LBMercado/Assistive-Wearable-Obstacle-Detection-System-using-Atmega328P/Codes/assistive-wearable-obstacle-detection-system/assistive-wearable-obstacle-detection-system.ino

#include "SPI.h"
#include "SD.h"
#include "Adafruit_VS1053.h"
/* --------------------------------------------------------------- */
//uncomment to enable debugging
//#define DEBUG
#include "DebugUtils.h"
/* --------------------------------------------------------------- */
/* Device Operating Configurations */
#ifdef DEBUG
#define BAUD_RATE                       9600
#endif
#define ITERATION_INTERVAL              0       //in milliseconds, amount of time to wait before next iteration
#define TRIGGER_WAIT_DURATION           60      //in milliseconds, wait before sending another trigger signal
#define MAX_DISTANCE                    200     //maximum distance considered in centimeters
#define MIN_DISTANCE                    10      //minimum distance considered in centimeters
#define PWM_VALUE_PERCENTAGE            100     //0 - 100, maximum output percentage PWM for vibration motors, adjust lower to reduce power consumption
#define STAIR_ELEV_DISTANCE             15      //in centimeters
#define VIBRATION_DURATION              100     //in milliseconds
#define DEFAULT_VOLUME                  20      //default starting volume, will adjust based on analog reading on volume adjust potentiometer.
#define VOLUME_ADJ_SENSITIVITY          50      //sensitivity of the volume adjust parameter, lower is more sensitive (1 - 1023)
#define VOLUME_ADJ_MAX                  1023 / VOLUME_ADJ_SENSITIVITY
#if VOLUME_ADJ_SENSITIVITY <= 0
#error "Volume Adjust Sensitivity cannot be less than or equal to zero."
#endif
#define MAX_CONSTANT_VIBRATION_TIME     3000    //in milliseconds
#define CONSTANT_VIBRATION_DIST_TOL     15      //in centimeters
/* --------------------------------------------------------------- */
/* PIN Configuration */
//    ultrasonic sensor pins
const unsigned short US_TRIG_PIN = 4;
const unsigned short US_ECHO_FRONT_PIN = 5;
const unsigned short US_ECHO_LEFT_PIN = 7;
const unsigned short US_ECHO_RIGHT_PIN = 8;
const unsigned short US_ECHO_STAIRS_PIN = 5;
//    PIR sensor pins
const unsigned short PIR_RX_LEFT_PIN = 7;
const unsigned short PIR_RX_RIGHT_PIN = 8;
//    output pin to drive vibration motors
const unsigned short PWM_PIN_RIGHT = 3;
const unsigned short PWM_PIN_FRONT = 6;
const unsigned short PWM_PIN_LEFT = 10;
//    selector pin for choosing between:
//      0 : ultrasonic sensors for general obstacles and common trigger
//      1 : ultrasonic sensor for stair detection, PIR sensors, and microsd card reader
const unsigned short SELECTOR_PIN = 2;
//    SPI pins common for sd card and vs1053 audio codec
// default MISO_PIN = 12;
// default MOSI_PIN = 11;
// default SCK_PIN = 13;
//    chip enable pin for sd card
const unsigned short SD_CS_PIN = 4;
//    extra pins for vs1053 audio codec
const unsigned short VS1053_DREQ = 9;
const unsigned short VS1053_XDCS = A2;
const unsigned short VS1053_SDCS = A1;
const unsigned short VS1053_XRST = A0;
//    speaker volume adjust
const unsigned short VOLUME_ADJ = A3;
/* --------------------------------------------------------------- */
//    TAKE NOTE OF THE SHARED PINS IN THIS CONFIG
//    D4 - OUTPUT PIN
//    D5 - INPUT PIN
//    D7 - INPUT PIN
//    D8 - INPUT PIN
/* --------------------------------------------------------------- */
unsigned short readUltrasonicState, readMovementState;
bool leftActivePrevious, rightActivePrevious;
bool VS1053CodecFailed, sdCardFailed;
unsigned long millisNow, frontMillis, leftMillis, rightMillis;
unsigned long prevFrontDist, prevLeftDist, prevRightDist;
unsigned short speakerVolume;
/* --------------------------------------------------------------- */
//output variable for stair detection algorithm
long prevStairDistance;
/* --------------------------------------------------------------- */
enum MOVEMENT_PATTERN {NO_MOVEMENT, RIGHTWARD, LEFTWARD};
/* --------------------------------------------------------------- */
Adafruit_VS1053_FilePlayer playback = 
  Adafruit_VS1053_FilePlayer(
    VS1053_XRST,
    VS1053_SDCS,
    VS1053_XDCS,
    VS1053_DREQ, 
    SD_CS_PIN);
/* --------------------------------------------------------------- */
void setup() {
  //ultrasonic pins
  pinMode(US_TRIG_PIN, OUTPUT);
  pinMode(US_ECHO_FRONT_PIN, INPUT);
  pinMode(US_ECHO_LEFT_PIN, INPUT);
  pinMode(US_ECHO_RIGHT_PIN, INPUT);
  //pir pins
  pinMode(PIR_RX_RIGHT_PIN, INPUT);
  pinMode(PIR_RX_LEFT_PIN, INPUT);
  //pwm vibration motor pins
  pinMode(PWM_PIN_RIGHT, OUTPUT);
  pinMode(PWM_PIN_FRONT, OUTPUT);
  pinMode(PWM_PIN_LEFT, OUTPUT);

  //other pins
  pinMode(SELECTOR_PIN, OUTPUT);
  pinMode(VOLUME_ADJ, INPUT);

  //initialize global variables
  readMovementState = readUltrasonicState = 0;
  frontMillis = leftMillis = rightMillis = millis();
  prevFrontDist = prevLeftDist = prevRightDist = 0;

  #ifdef DEBUG
  Serial.begin(BAUD_RATE);
  #endif

  //pull the chip select lines low
  
  selectDeviceLine(1);
  VS1053CodecFailed = !playback.begin();
  if (!VS1053CodecFailed){
    speakerVolume = DEFAULT_VOLUME;
    playback.setVolume(speakerVolume, speakerVolume);
    playback.useInterrupt(VS1053_FILEPLAYER_TIMER0_INT);
  }

  sdCardFailed = !SD.begin(SD_CS_PIN);
  #ifdef DEBUG
  if (!sdCardFailed) {
    // list files in directory
    printDirectory(SD.open("/"), 0);
  }
  #endif
  
  if (!VS1053CodecFailed && !sdCardFailed){
    startTone();
    delay(500);
    beginVibrationMotors();
  } else {
    beginErrorVibrationMotors();
  }
  
  DEBUG_PRINTLN("Starting internal debugger.");
}
/* --------------------------------------------------------------- */
void loop() {
  long durationMeasured, distanceMeasuredInCm;
  bool leftActive, rightActive;
  unsigned int rawVol, newVol;

  selectDeviceLine(1);
  //adjust volume when value changes
  rawVol = analogRead(VOLUME_ADJ) / VOLUME_ADJ_SENSITIVITY;
  newVol = map(rawVol, 0, VOLUME_ADJ_MAX, 0, 20); //lower is louder, 20 is barely audible
  if (newVol != speakerVolume) {
    speakerVolume = newVol;
    playback.setVolume(speakerVolume, speakerVolume);
  }
  
  // motion detection and stair detection
  // will refuse to work if audio is not initialized properly
  if (!sdCardFailed && !VS1053CodecFailed)
  {
    leftActive = digitalRead(PIR_RX_LEFT_PIN) == HIGH;
    rightActive = digitalRead(PIR_RX_RIGHT_PIN) == HIGH;
    switch(readMovementState){
      case 0:
        //record initial position
        leftActivePrevious = leftActive;
        rightActivePrevious = rightActive;
        readMovementState++;
        break;
      case 1:
        //record final position
        enum MOVEMENT_PATTERN pattern;
        pattern = determineMovementPattern(leftActive, rightActive, leftActivePrevious, rightActivePrevious);
        if (pattern == RIGHTWARD)
          playback.playFullFile("/right.mp3");
        else if (pattern == LEFTWARD)
          playback.playFullFile("/left.mp3");
        //NO_MOVEMENT pattern or values unaccounted for will do nothing
        readMovementState--;
        DEBUG_PRINT("Prev. PIR Left: ");
        DEBUG_PRINTLN(leftActivePrevious);
        DEBUG_PRINT("Prev. PIR Right: ");
        DEBUG_PRINTLN(rightActivePrevious);
        DEBUG_PRINT("Curr. PIR Left: ");
        DEBUG_PRINTLN(leftActive);
        DEBUG_PRINT("Curr. PIR Right: ");
        DEBUG_PRINTLN(rightActive);
        break;
      default:
        readMovementState = 0;
    }

    //  consider elevated obstacle detection first before horizontal obstacle
    switch (readUltrasonicState)
    {
      //record initial distance
      case 0:
        //  select line 0 to choose the US sensor devices and common trigger
        selectDeviceLine(0);
        triggerUltrasonicSensor(US_TRIG_PIN);
        //  select line 1 to choose the microsd card reader, PIR sensors, and US sensor for stair detection
        selectDeviceLine(1);

        durationMeasured = pulseIn(US_ECHO_STAIRS_PIN, HIGH);
        prevStairDistance = microsecondsToCentimeters(durationMeasured);
        if (prevStairDistance > 400) prevStairDistance = 0;
        readUltrasonicState++;
        break;
      //record final distance and compare, then clear
      case 1:
        long finalDistanceMeasured;
        //  select line 0 to choose the US sensor devices and common trigger
        selectDeviceLine(0);
        triggerUltrasonicSensor(US_TRIG_PIN);

        //  select line 1 to choose the microsd card reader, PIR sensors, and US sensor for stair detection
        selectDeviceLine(1);

        durationMeasured = pulseIn(US_ECHO_STAIRS_PIN, HIGH);
        finalDistanceMeasured = microsecondsToCentimeters(durationMeasured);
        if (finalDistanceMeasured > 400) finalDistanceMeasured = 0;
        //compare if there is a significant change in elevation
        //Republic Act No. 6541 - SECTION 3.01.08 - (h)
        if (abs(finalDistanceMeasured - prevStairDistance) >= STAIR_ELEV_DISTANCE)
          playback.playFullFile("/elev.mp3");
        readUltrasonicState--;
        DEBUG_PRINT("Prev Dist: ");
        DEBUG_PRINTLN(prevStairDistance);
        DEBUG_PRINT("Final Dist: ");
        DEBUG_PRINTLN(finalDistanceMeasured);
        DEBUG_PRINT("Elevation: ");
        DEBUG_PRINTLN(abs(finalDistanceMeasured - prevStairDistance));
        break;
      default:
        readUltrasonicState = 0;
    }
  }

  //  select line 0 to choose the US sensor devices and common trigger
  selectDeviceLine(0);
  
  millisNow = millis();
  // account for possibility of overlapping triggers from vertical ultrasonic trigger
  while(millis() < millisNow + TRIGGER_WAIT_DURATION);
  // The PING))) is triggered by a HIGH pulse of 2 or more microseconds.
  // Give a short LOW pulse beforehand to ensure a clean HIGH pulse:
  // a HIGH pulse
  // whose duration is the time (in microseconds) from the sending of the ping
  // to the reception of its echo off of an object.
  triggerUltrasonicSensor(US_TRIG_PIN);
  durationMeasured = pulseIn(US_ECHO_FRONT_PIN, HIGH);
  distanceMeasuredInCm = microsecondsToCentimeters(durationMeasured);
  if (abs(distanceMeasuredInCm - prevFrontDist) < CONSTANT_VIBRATION_DIST_TOL) {
    // still within vibration time duration
    if (millis() <= frontMillis + MAX_CONSTANT_VIBRATION_TIME) {
      driveMotor(distanceMeasuredInCm, PWM_PIN_FRONT, VIBRATION_DURATION);
    } 
  } else {
    driveMotor(distanceMeasuredInCm, PWM_PIN_FRONT, VIBRATION_DURATION);
    frontMillis = millis();
  }
  prevFrontDist = distanceMeasuredInCm;
  millisNow = millis();
  // account for possibility of overlapping triggers
  while(millis() < millisNow + TRIGGER_WAIT_DURATION);

  triggerUltrasonicSensor(US_TRIG_PIN);
  durationMeasured = pulseIn(US_ECHO_LEFT_PIN, HIGH);
  distanceMeasuredInCm = microsecondsToCentimeters(durationMeasured);
  if (abs(distanceMeasuredInCm - prevLeftDist) < CONSTANT_VIBRATION_DIST_TOL) {
    // still within vibration time duration
    if (millis() <= leftMillis + MAX_CONSTANT_VIBRATION_TIME) {
      driveMotor(distanceMeasuredInCm, PWM_PIN_LEFT, VIBRATION_DURATION);
    }
  } else {
    driveMotor(distanceMeasuredInCm, PWM_PIN_LEFT, VIBRATION_DURATION);
    leftMillis = millis();
  }
  prevLeftDist = distanceMeasuredInCm;
  millisNow = millis();
  // account for possibility of overlapping triggers
  while(millis() < millisNow + TRIGGER_WAIT_DURATION);

  triggerUltrasonicSensor(US_TRIG_PIN);
  durationMeasured = pulseIn(US_ECHO_RIGHT_PIN, HIGH);
  distanceMeasuredInCm = microsecondsToCentimeters(durationMeasured);
  if (abs(distanceMeasuredInCm - prevRightDist) < CONSTANT_VIBRATION_DIST_TOL) {
    // still within vibration time duration
    if (millis() <= rightMillis + MAX_CONSTANT_VIBRATION_TIME) {
      driveMotor(distanceMeasuredInCm, PWM_PIN_RIGHT, VIBRATION_DURATION);
    } 
  } else {
    driveMotor(distanceMeasuredInCm, PWM_PIN_RIGHT, VIBRATION_DURATION);
    rightMillis = millis();
  }
  prevRightDist = distanceMeasuredInCm;
  millisNow = millis();
  // account for possibility of overlapping triggers
  while(millis() < millisNow + TRIGGER_WAIT_DURATION);

  turnOffMotor(PWM_PIN_FRONT);
  turnOffMotor(PWM_PIN_LEFT);
  turnOffMotor(PWM_PIN_RIGHT);

  delay(ITERATION_INTERVAL);
}
/* --------------------------------------------------------------- */
long microsecondsToCentimeters(long microseconds) {
  // The speed of sound is roughly 340 m/s or 29 microseconds per centimeter.
  // This does not take into account the temperature of the surroundings.
  // The actual formula is d = 334 + 0.6*T where T is the ambient temperature
  // The ping travels out and back, so to find the distance of the object we
  // take half of the distance travelled.
  return microseconds / 58;
}
/* --------------------------------------------------------------- */
void triggerUltrasonicSensor(unsigned int TRIGGER_PIN)
{
  digitalWrite(TRIGGER_PIN, LOW);
  delayMicroseconds(2);
  digitalWrite(TRIGGER_PIN, HIGH);
  delayMicroseconds(10);
  digitalWrite(TRIGGER_PIN, LOW);
}
/* --------------------------------------------------------------- */
void driveMotor(long distanceMeasured, unsigned int motor_pin, unsigned int vibrationDuration)
{
  unsigned int pwmVal;
  if (distanceMeasured > MAX_DISTANCE || distanceMeasured <= 0) return;
  distanceMeasured = constrain(distanceMeasured, MIN_DISTANCE, MAX_DISTANCE);
  pwmVal =  map(distanceMeasured, MIN_DISTANCE, MAX_DISTANCE, 255 * PWM_VALUE_PERCENTAGE / 100, 0);
  DEBUG_PRINT("Motor Pin: ");
  DEBUG_PRINTLN(motor_pin);
  DEBUG_PRINT("Motor PWM: ");
  DEBUG_PRINTLN(pwmVal);
  
  analogWrite(motor_pin, pwmVal);
  delay(vibrationDuration);
}
/* --------------------------------------------------------------- */
void turnOffMotor(unsigned int motor_pin)
{
  analogWrite(motor_pin, 0);
}
/* --------------------------------------------------------------- */
void beginVibrationMotors()
{
  for (unsigned int i = 0; i < 3; i++){
    driveMotor(10, PWM_PIN_RIGHT, VIBRATION_DURATION);
    driveMotor(10, PWM_PIN_FRONT, VIBRATION_DURATION);
    driveMotor(10, PWM_PIN_LEFT, VIBRATION_DURATION);
    delay(100);
    turnOffMotor(PWM_PIN_FRONT);
    turnOffMotor(PWM_PIN_LEFT);
    turnOffMotor(PWM_PIN_RIGHT);
  }
}
/* --------------------------------------------------------------- */
void beginErrorVibrationMotors()
{
  for (unsigned int i = 0; i < 3; i++){
    driveMotor(10, PWM_PIN_RIGHT, VIBRATION_DURATION);
    driveMotor(10, PWM_PIN_FRONT, VIBRATION_DURATION);
    driveMotor(10, PWM_PIN_LEFT, VIBRATION_DURATION);
    delay(500);
    turnOffMotor(PWM_PIN_FRONT);
    turnOffMotor(PWM_PIN_LEFT);
    turnOffMotor(PWM_PIN_RIGHT);
  }
}
/* --------------------------------------------------------------- */
void startTone()
{
  playback.playFullFile("/start.mp3");
}
/* --------------------------------------------------------------- */
void selectDeviceLine(unsigned int lineNumber)
{
  switch (lineNumber)
  {
    case 0:
      // select line 0 to choose the US sensor devices and common trigger
      digitalWrite(SELECTOR_PIN, LOW);
      break;
    case 1:
      // select line 1 to choose the microsd card reader, PIR sensors, and US sensor for stair detection
      // pull the select line high first for microsd card reader to prevent accidental SPI comms
      digitalWrite(SD_CS_PIN, HIGH);
      digitalWrite(SELECTOR_PIN, HIGH);
      break;
    default:
      digitalWrite(SELECTOR_PIN, HIGH);
  }
}
/* --------------------------------------------------------------- */
enum MOVEMENT_PATTERN determineMovementPattern(bool leftCurrent, bool rightCurrent, bool leftPrev, bool rightPrev){
  if (leftPrev && leftCurrent && rightPrev && rightCurrent)
    return NO_MOVEMENT;
  else if (leftPrev && rightCurrent){
    return RIGHTWARD;
  }
  else if (rightPrev && leftCurrent){
    return LEFTWARD;
  }
  else {
    return NO_MOVEMENT;  
  }
}
/* --------------------------------------------------------------- */
/// File listing helper
void printDirectory(File dir, int numTabs) {
   while(true) {
     File entry =  dir.openNextFile();
     if (! entry) {
       // no more files
       break;
     }
     for (uint8_t i=0; i<numTabs; i++) {
       DEBUG_PRINT('\t');
     }
     DEBUG_PRINTLN(entry.name());
     if (entry.isDirectory()) {
       DEBUG_PRINTLN("/");
       printDirectory(entry, numTabs+1);
     } else {
       // files have sizes, directories do not
       DEBUG_PRINT("\t\t");
       DEBUG_PRINTLN(entry.size(), DEC);
     }
     entry.close();
   }
}
/* --------------------------------------------------------------- */
