LBMercado/Assistive-Wearable-Obstacle-Detection-System-using-Atmega328P/Codes/assistive-wearable-obstacle-detection-system/DebugUtils.h

/*
DebugUtils.h - Simple debugging utilities.
Ref: https://forum.arduino.cc/index.php?topic=64555.0
*/

#ifndef DEBUGUTILS_H
#define DEBUGUTILS_H

#ifdef DEBUG
  #define DEBUG_PRINT(...) Serial.print(__VA_ARGS__)
  #define DEBUG_PRINTLN(...) Serial.println(__VA_ARGS__)
#else
  #define DEBUG_PRINT(...)
  #define DEBUG_PRINTLN(...)
#endif

#endif
