LBMercado/Assistive-Wearable-Obstacle-Detection-System-using-Atmega328P/(commit log)

2020-02-23 Update assistive-wearable-obstacle-detection-system.ino
    Moved DEBUG definition before DebugUtils.h inclusion to fix serial not printing bug and some minor debug info adjustments.
    [assistive-wearable-obstacle-detection-system.ino]
2020-03-30 Update README.md
    Separated circuit into two parts: main and sensor circuit
2020-05-29 Optimized pwm value calculation
    Major Improvements:
    *Removed the static level system (lvl 1, 2 etc.) for detected obstacles. The system itself instead relies on the measured distance mapped to pwm value depending on the maximum distance that can be measured by the ultrasonic sensors.
    *From above, revised the driveMotor function to map the distanceMeasured input to the pwm value.
    *Also in driveMotor function, removed boolean enables with the motor pin itself.
    Other improvements:
    *Compacted repetitive code to a loop. (startTone, errorTone, and beginVibrationMotor functions)
    [assistive-wearable-obstacle-detection-system.ino]
2020-08-19 Add delay between ultrasonic sensor measurements
    - Add delay before attempting to send a trigger signal to ultrasonic sensor to account for overlapping triggers
    - Make driveMotor function do nothing when distance measured exceeds MAX_DISTANCE.
2020-09-02 Replace TMRpcm/pcmRF with Adafruit VS1053
    [assistive-wearable-obstacle-detection-system.ino]
2020-09-20 Update assistive-wearable-obstacle-detection-system.ino
    - Fix bug sd card not initializing properly.
    - Simplify playback init in constructor.
    - Make volume adjustment start from 20 (least audible based on trials)
    - Remove interrupt-based playback due to shared pin with sd card in select line.
    - Fix wrong filename length used in mp3 playback.
    [assistive-wearable-obstacle-detection-system.ino]
2020-12-04 add gerber files for pcbs
2020-12-04 Update README.md
    - replace google link images with repo img sources
    - add prototype image
2020-12-12 Revamp debugging code
    - Reduce debugging code to fit into memory of MCU
    - Set default PWM strength to 100%.
2020-12-19 Add error vibration motor pattern upon startup
    [assistive-wearable-obstacle-detection-system.ino]
2021-01-26 Add constant vibration time limit
    - Limit time vibration motors activate based on constant distances.
    - Adjust max distance to 100 cm.
    - Add minimum distance of 10 cm,
    - Adjust stair elevation distance to 10 cm.
    [assistive-wearable-obstacle-detection-system.ino]
2021-01-30 Adjust Default Settings
    - Reduce iteration interval to zero to improve performance.
    - Increase max obstacle distance to 200 cm.
    - Increase stair distance to 15 cm.
    - Reduce constant vibration time to 3 seconds.
    - Increase constant vibration distance tolerance to 15 cm.
    [assistive-wearable-obstacle-detection-system.ino]
2021-01-31 Restrict vertical ultrasonic distances to valid range
    - Limit out of bound measurements to allowed range (400 cm).
    - Add wait operation at end of right ultrasonic measurement to account for overlapping with vertical ultrasonic measurement.
    - Add debugging code to vertical ultrasonic measurement
